FVSproject/ulcershield-ai/(commit log)

2026-08-26 Initial commit — UlcerShield AI platform
    Adaptive multi-modal AI platform for pressure injury prevention.
    Includes:
    - Next.js 16 web platform (app/) with EN/AR/KO i18n, admin + patient roles,
    personalized Digital Tissue Twin, 3D anatomical body (adult + baby),
    Claude API integration, IndexedDB local storage
    - ESP32 BLE peripheral firmware (firmware/)
    - Legacy WiFi/HTTP firmware (BedsorePredictor.ino, data/)
    - Algorithm documentation (docs/algorithm.md) — Reswick-Rogers curve +
    Braden/Waterlow-inspired personalization cascade
    Ready for Vercel deploy — see platform/DEPLOY.md
    [BedsorePredictor.ino, BedsorePredictorBLE.ino, app.js]
2026-08-26 Body3D: remove useGLTF.preload for missing body.glb
    The preload call unconditionally fetched /models/body.glb on every page
    load, producing a 404 in the browser console. The HEAD-probe pattern in
    BodyAuto() already gates the real fetch — if the file exists it loads,
    otherwise the procedural anatomical mannequin renders. No preload
    needed.
2026-08-26 Claude API: enforce output language per user selection
    The previous prompt buried the language directive after the patient JSON
    in the user message. The cached English system prompt then dominated,
    and Claude routinely replied in English even when Arabic or Korean was
    requested.
    Fixes:
    1. Hoist a strong per-language directive to the TOP of the user message,
    with a short example demonstrating the required tone and register.
    2. Add a rule 6 to the system prompt stating language output is the
    highest-priority requirement (still cacheable — no per-request vary).
    3. Update every Zod schema field description to require 'the requested
    language' for user-visible strings.
    4. Keep numeric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
2026-08-26 docs: full user guide in EN + AR, print-optimized for PDF
    Three new HTML files under platform/public/docs/:
    - index.html — landing page with EN/AR language picker (dark themed,
    matches platform aesthetic)
    - user-guide-en.html — 20-section English guide covering every feature:
    intro, platform overview, getting started, landing, dashboard tour
    (14 cards), 3D Digital Tissue Twin (adult + baby), Remaining Safe
    Tissue Time algorithm with worked example, 5-axis risk index,
    Claude AI panel, admin dashboard + impersonation, analysis + export,
    BLE device connection, profile management, full algorithm derivation
    with modifier tables, privacy & data model, multi-language & themes,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
2026-08-27 feat: personalized turn angle + interval + post-turn verification; add /about and /roadmap
    Grounds every repositioning recommendation in the evidence base and gives
    caregivers direct feedback on whether the intervention worked.
    - tissue-twin: recommendedTiltAngle() scales 30° / 35° / 40° by BMI and
    patient type; personalizedTurnInterval() adapts to risk band, age,
    skin temperature, and humidity (clamped to [60, 240] min).
    - ai-recommendation: 5-minute post-turn verification. Snapshots peak
    pressure on Apply, compares after 5 min — ≥30% drop is confirmed
    success, otherwise flags for re-check. Expandable "Why {angle}°?"
    panel explains the tilt choice.
    - turn-ring: uses perso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
2026-08-27 feat(evaluate): adaptive angle escalation when post-turn verification fails
    Extends the closed loop's Evaluate step. When the 5-min post-turn check
    shows peak pressure did NOT drop by ≥30%, the card now proposes a
    specific next step instead of only warning:
    - Angle < 40° → bump 5° on the SAME side (30°→35°, 35°→40°).
    - Angle = 40° → switch to the OPPOSITE side at 30° (EPUAP/NPUAP:
    above 40° concentrates load over bony prominences).
    - Flat / unknown → prompt reassessment.
    Accepting the escalation starts a fresh 5-min verification window
    against the post-first-turn peak, so the system measures cumulative
    effect rather than resetting the baseline.
    Also labels the verif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
2026-08-28 feat: adult/kid patient type, standalone Evaluate card, SOS alerts, /help page
    Four features in one drop:
    1) Patient type: adult (13+) or kid (<13)
    - Renames "baby" → "kid" and raises the threshold from <2 to <13.
    - Keeps an internal isInfant() gate (age < 2) so infants still get the
    tighter tissue parameters (Pcap=20, K=2500, ceiling=180); 2–12 y
    use an intermediate profile (Pcap=25, K=3300, ceiling=210).
    - Adds a new REGION_WEIGHTS_CHILD table between infant and adult.
    - Dexie v4 migration silently converts existing "baby" rows to "kid".
    - i18n keys renamed across EN / AR / KO.
    2) Evaluate card — dedicated dashboard card
    - Extracts verification + escalat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
2026-10-13 feat(firmware): v5.1 BLE pairing fixes; move sketch into its own folder
    - Advertise the device name in the scan response. It overflowed the
    31-byte advertisement next to the 128-bit service UUID and was dropped,
    so the browser chooser listed an unnamed device.
    - Request a 247-byte MTU from the peripheral on connect; Chrome on
    Android < 14 never negotiates, which truncated every JSON packet.
    - Keep advertising while connected (up to 3 screens) and after a
    disconnect, so a page reload can re-pair immediately.
    - Send a status event and a fresh state packet as soon as a browser
    subscribes.
    - Report failed mass calibration as an "alert" instead of success.
    - Build JSON with snprintf (dr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
2026-10-13 fix(ble): use device turn timer, isolate device stream from simulator
    - Clear the store before BLE notifications start so the simulator's last
    reading no longer seeds the device stream (its since-turn timer leaked
    into the real data).
    - Take minutes-since-turn from the device's `st` field instead of
    extrapolating from the previous state.
    - Switching the viewed patient no longer starts the simulator while a
    BLE device is connected, which interleaved fake and real readings.
    - A cancelled chooser or failed GATT connection no longer leaves the UI
    stuck on "connecting"; /connect falls back to the simulator.
    - Re-pairing to a different device drops the old link first.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
2026-10-14 feat(firmware): v5.2 bed tilt servo for demo bed v2
    The MG996R rolls the bed's pillow tray on its long axis, carrying out the
    Intervene step of the loop.
    - New command "tilt:<deg>": clinical angle, + = right side down, 0 = flat.
    The v2 tray only rolls +-20 deg, so it moves at TILT_SCALE = 0.5 of the
    clinical angle (30 -> 15, 40 -> 20), capped at 40 clinical / 20 tray.
    - Servo on GPIO 13 via LEDC (50 Hz, 14-bit), no extra library. Ramps at
    5 deg/s, starts flat at boot, SERVO_INVERT / SERVO_CENTER_US for trim.
    - A completed tilt registers a turn; CoP turn detection pauses while the
    tray is moving so the sweep isn't counted twice.
    - State packets add "tl"/"tt"/"tb" (current, target, tr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
2026-10-14 feat(platform): drive the bed tilt servo; fix manual disconnect and simulator switch
    Bed tilt
    - Apply on a lateral recommendation and accepting an Evaluate escalation
    tilt a paired bed (tilt:<+/-angle>); silent when no tilt servo.
    - Controls card: Bed tilt row with Left / Flat / Right at the patient's
    personalised angle, plus live current -> target and tray angle.
    - Parse "tl"/"tt"/"tb" into SensorState.tilt (null without a servo).
    - Help: BED-01 "The bed does not tilt". EN / AR / KO strings.
    Disconnect / simulator
    - Disconnect on /connect no longer raises the "BLE sensor disconnected"
    SOS: user-initiated disconnects end "idle", only a dropped link ends
    "disconnected". The dashboard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
2026-10-14 fix(firmware): v5.3 skin temperature smoothing, stale-value fix, calibration
    - A failed MLX90614 read returns -273.15 C; the sketch rejected it but kept
    sending the last good value forever. After 3 s of failures "b" is now
    null and the sensor is re-probed every 5 s.
    - Read every 0.5 s and report the median of the last 5 reads.
    - New "temp_ref:<C>" one-point calibration against a thermometer (30-43 C,
    offset capped at 10 C); stored in NVS so it survives reboots.
    "temp_ref:clear" removes it. State packets carry "bo" (offset).
    - README and user guides explain skin vs. thermometer temperature and how
    to calibrate.
2026-10-14 feat(platform): skin temperature calibration from the dashboard
    - Calibration & controls: Temperature calibration row. Enter a thermometer
    reading taken with the sensor on the skin; sends temp_ref:<C> (or
    temp_ref:clear) to firmware v5.3+, shows the current offset.
    - Vitals card hint says whether the reading is an uncalibrated skin reading
    or calibrated, so a low raw value isn't mistaken for a fault.
    - Parse "bo" into SensorState.tempOffsetC.
    - Help: SENS-03 "Temperature reads lower than a thermometer". EN/AR/KO.
2026-10-14 fix(firmware): v5.4 bed level calibration, 25 deg tray tilt for 35 clinical
    - Level: on the Fab Lab bed the tray was level at v5.3's "right 35"
    command (17.5 servo deg). TILT_LEVEL_TRIM_DEG makes that position Flat;
    the trim is applied before SERVO_INVERT so it holds either way.
    '[' / ']' in the Serial Monitor shift it by 0.5 deg and save to NVS.
    - Scale: a 35 deg clinical tilt now rolls the tray 25 deg
    (TILT_SCALE = 25/35; 30 -> 21.4, 40 -> 28.6). Tray limit 20 -> 30 deg.
    - README, help (BED-01) and user guides updated.
2026-10-17 feat(firmware): ESP32-CAM bed camera with MJPEG live stream
    New sketch firmware/UlcerShieldCam for the demo bed's AI Thinker
    ESP32-CAM (HW-818).
    - Joins Wi-Fi (WIFI_SSID / WIFI_PASS), mDNS ulcershield-cam.local, falls
    back to an "UlcerShield-CAM" access point if it can't join.
    - Port 80: /status (JSON), /control?camera=on|off, /capture, test page.
    Port 81: /stream MJPEG, on its own server so it never blocks /status.
    - camera=off waits for in-flight frames, deinits the driver and powers the
    sensor down; frame buffers are handed out under a mutex so on/off can't
    race a stream.
    - VGA with PSRAM (QVGA without), GRAB_LATEST for low latency, CORS on all
    responses so the HTTPS platform c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
2026-10-17 feat(platform): Live feed card for the ESP32-CAM bed camera
    - Dashboard "Live feed": Start / Stop camera (sends camera=on|off and
    opens/closes the MJPEG stream), simulated Record with REC timer and a
    clip list with thumbnails from /capture (marked "demo", nothing stored),
    editable camera address (default ulcershield-cam.local, saved locally).
    - Shows resolution / fps / signal from /status, polled every 3 s while
    live; detects a lost camera, a busy camera (one viewer at a time), an
    unreachable address and blocked local network access, each with a fix.
    - Nothing contacts the camera until Start is pressed, so Chrome's local
    network access prompt always follows a click.
    - Help: CAM-0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
